Dennis40816/hand_pcb/pcb/hand_sensor_origin_footprint_v1/fabrication_files/hand_fpc_v1_bom.xlsx

Comment | Designator | Footprint | Supplier Part
4.7uF | C31, C47 | C1206_FPC | C29823
22Ω | R29, R30, R31, R32, R33 | R1206_FPC | C17958
100nF | C26, C27, C28, C29, C30, C32, C33, C34, C35, C36, C37, C38, C39, C40, C41, C42, C43, C44, C45, C46 | C1206_FPC | C24497
B54102H1020A001 | U9, U11, U21, U22 | B54102H1020A001 | C17316382
BMI323 | U15 | BMI323 | C5368700
CH 101 02ABR | U8, U14, U16, U20 | XDCR_CH-101 | C1513113
KX132-1211 | U12, U13, U17, U18 | LGA-12_L2.0-W2.0-P0.50-TL | C2157931
VL53L1CXV0FY/1 | U10, U19 | SENSOR_VL53L1CXV0FY/1 | C190004
