Dennis40816/hand_pcb/pcb/fabrication/README.md

# Fabrication Readme

## Gerber

- The Altium Designer file for the sensor board is directly submitted for fabrication. Therefore there's no gerber files for sensor board.

## Stencils

- The file to fabricate stencils, provided from JLC.

## AD Zip

- The backup for pcb project files
