Dennis40816/hand_pcb/design_guide/HAND design guide.pptx

## HAND 設計詳解

2024/05/06
製作人: 劉尚賢

## 總述

- HAND 是一款結合超聲波感測器、ToF、壓電致動器、IMU等功能的感知回饋系統，旨在以觸覺方式提醒周圍是否有異物，及相關附加功能
- HAND: Haptic Asistance Nevigation Device
- HAND 分成主板(hand_main)以及 FPC (hand_fpc)
- Hand_main 又可以分成 Main 區域(主要功能區)和 PDN (Power Delivery Network)區域

## HAND PDN USB Connector

## Slide 4

OUT: 通常指上位機
IN: 通常指嵌入式設備端

參考 layout

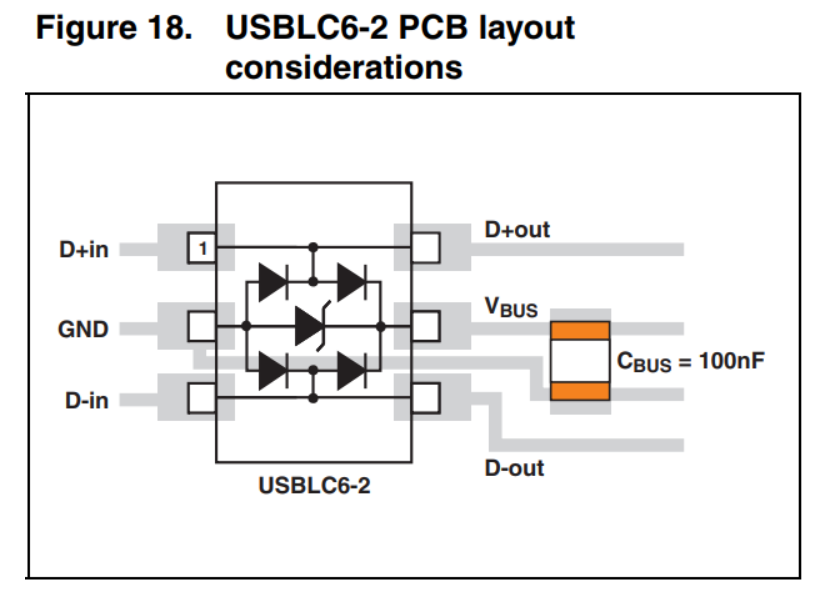
[picture p7: figure]
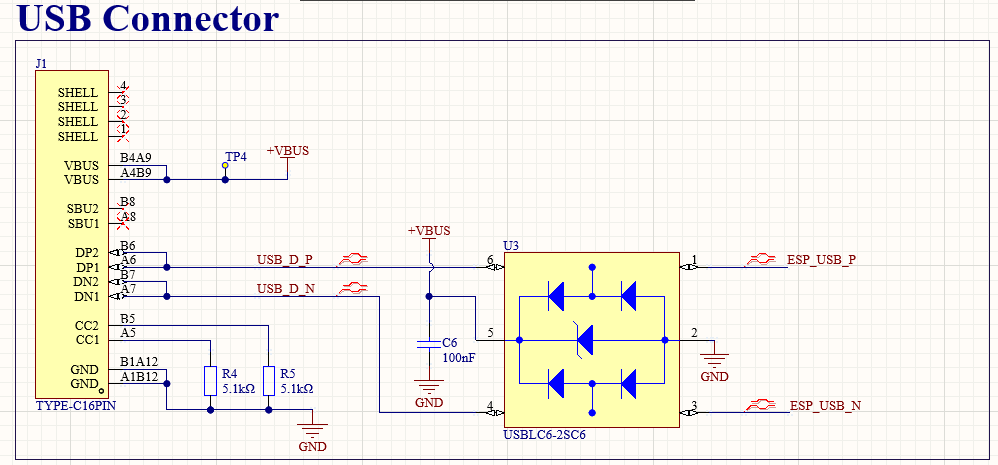
[picture p8: figure]

CC1, CC2 Rp 電阻，用於表示汲取電壓電流範圍，5.1k 表示 5V3A (不用任何通訊，前提是上位機支持)

Type-C 母接頭

USB Data line ESD 保護

D+, D- 差分線

C6

往 ESP32 的 USB 差分線

## HAND PDN Battery Charger

## Slide 6

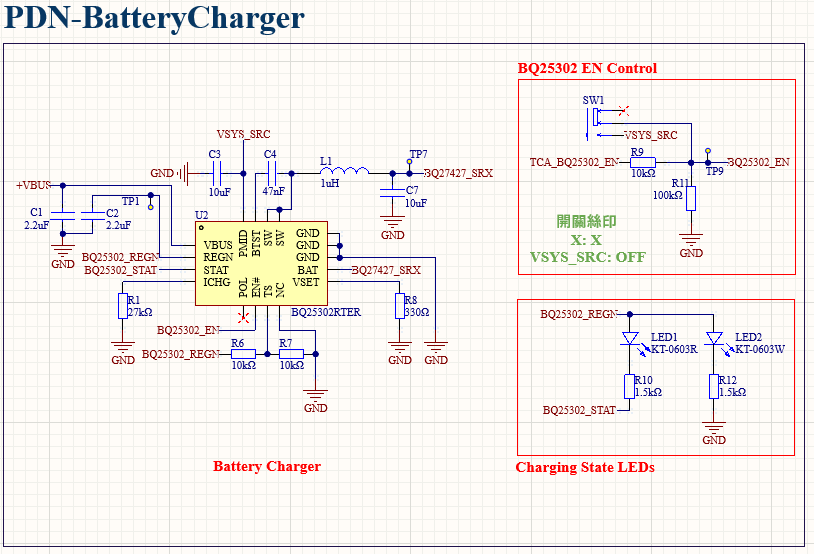
[picture p9: figure]

需與 Fuel Gauge 一起觀看

OVERVIEW

- 使用 BQ25302 作為電池充電的管理 IC
- 該 IC 可以設定充電電壓 (此處為 4.2 V) 和電流 (此處約 1.5A Max)
- 輸出至 PDN 的 net name 為 BQ27427_SRX
- 該 IC 可以藉由右側的開關決定是否啟動

BQ25302 (https://www.ti.com/lit/gpn/bq25302) (https://www.ti.com/lit/gpn/bq25302)datasheet (https://www.ti.com/lit/gpn/bq25302)

DATASHEET

TI E2E: BQ25302 sch review (https://e2e.ti.com/support/power-management-group/power-management/f/power-management-forum/1349813/tps63806-tps63806-bq25302-bq27427-schematic-review/5157413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)

可以查看 Figure 9-6

## About Settings…

電壓設置

電流設置

根據手冊，充電的最高電壓值由 VSET 腳位對地的電阻決定，此處選用 330 Ohm (R1) 使電壓設定成 4.2 V。
另外值得注意的是，VSET 直接接地和浮接好像會有問題。

根據手冊，充電的最高電流值由 ICHG 腳位對地的電阻決定，此處選用 27k Ohm (R8) 使電壓設定成 40,000(KICHG) / 27,000 = 1.48A。
另外值得注意的是， ICHG 直接接地和浮接好像會有問題。

## Slide 8

這個 EN 控制電路集合了硬體和軟體能夠對 BQ25302_EN 進行控制

當 SW1 在常開側，開關浮接，此時 BQ25302_EN 可以由 TCA_BQ25302_EN 的電位決定 (由 10k 和 100k 分壓可知)，當 SW1 切換到 VSYS_SRC (> 3.3V)，則 BQ25302_EN 被強上拉，強制關閉 (BQ25302 是低電位始能)

BQ25302 的 REGN 是其內部 5V 的 LDO 輸出，負責 LED 供電 LED 狀態燈，閃爍情況請見手冊

電容和電感請參考手冊選值 (Table 6-1. Pin Functions)

Default pull
down resistor

手冊提到當 TS沒有用到時，要透過 10k 電阻連接

## HAND PDN Fuel Gauge

## Slide 10

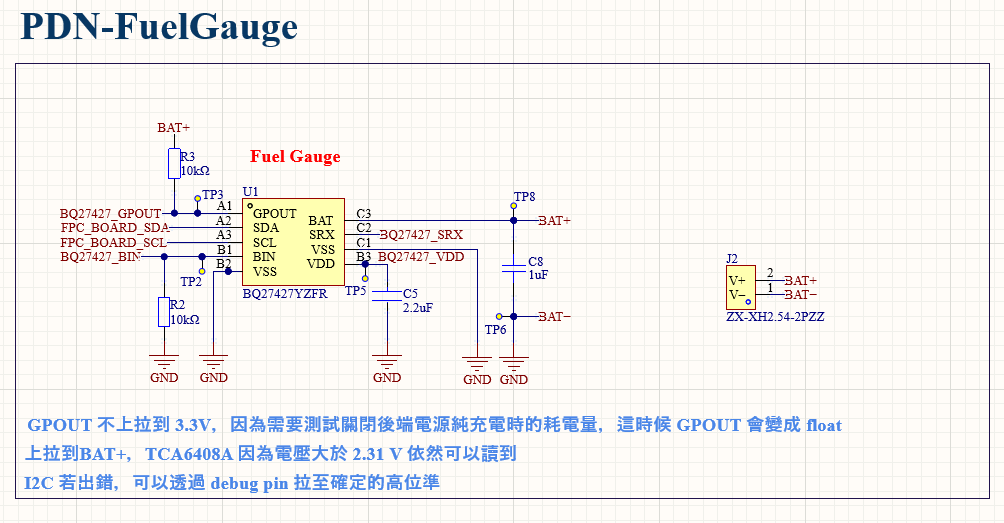
[picture p10: figure]

上拉到 BAT+ 而非 3.3V 原因下面有寫，BAT+ 沒接的時候也不重要，因為 BQ27427 不會啟動

Fuel gauge 是用來查看目前剩餘電量的 IC，BQ27427 裡面自帶電流量測電阻(在 BAT 和 SRX 之間)，最大的電流為 2A RMS

可使用 I2C 跟 MCU進行溝通，請注意只有當電池插入時，I2C 才是可用的

SRX 是對外的接口，所以跟充電 IC 連接

偵測電池是否插入
沒有用的時候使用 10k 下拉

BQ27427 datasheet (https://www.ti.com/lit/gpn/bq27427)

## HAND PDN Load Sharing

## Slide 12

Back to back (https://electronics.stackexchange.com/a/428175)pmos (https://electronics.stackexchange.com/a/428175)

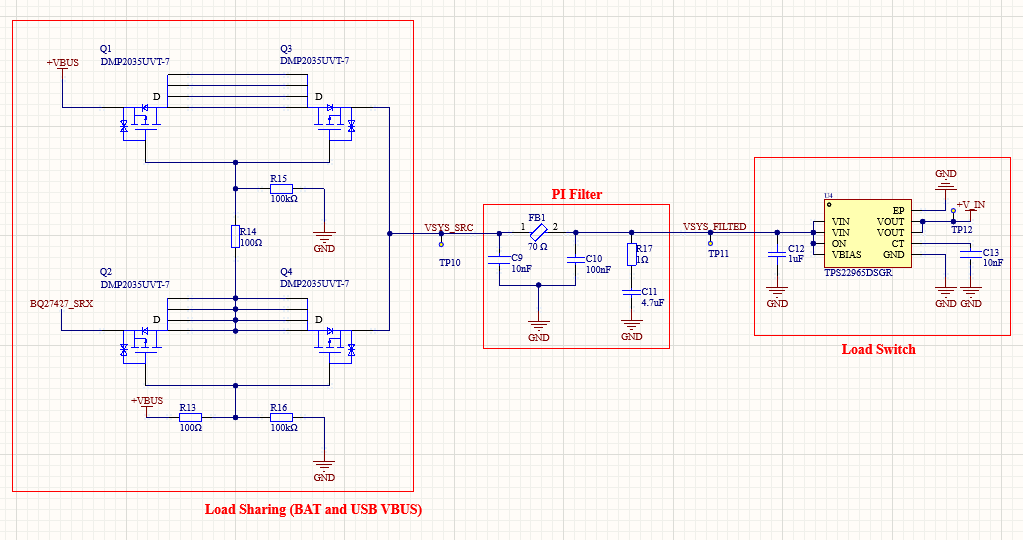
[picture p11: figure]

Back to back pmos 相較於 pmos + 蕭特基二極體的方案具有更低的損耗，在此 VBUS 優先使用，如果沒插才換 BQ27427_SRX

這主要是防止上電時出現 inrush current，尤其是對 USB 而言

防止 gate inrush current

Pi filter 用於過濾高頻，R17 和 C11 是用於抑制前面 pi filter 的共振頻率(見後)

C13 控制延遲時間，對於 3.3V 約為 11 ms，5V 約為 19ms

TPS22965 datasheet (https://www.ti.com/lit/gpn/tps22965)

確保未插入時的電位為低 避免意外導通

## 有關原理與損耗 …

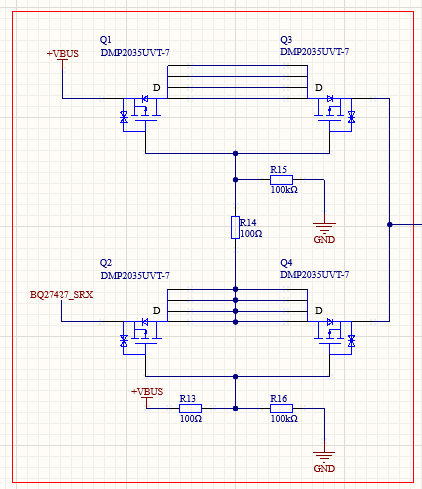
[picture p12: figure]

D

USB 插入

損耗

S

S

- 當 USB 插入，+VBUS 生壓至 5V，此時，原本打開的 BQ27427_SRX 會開始關閉(因為 VGS 不再 < Vth, 注意 PMOS 的 Vth 為負值，要 < Vth 才會導通!!)
- 當下方的 PMOS 管關閉後，電壓會被拉至 Default 0V，此時，上方的 VGS 就會低於 Vth ，因此上方導通

與第一個版本相比(見 A.1 章節)，這個版本在 3A 的電流下，功耗是 3*3*0.09 ~ 0.81(W)，0.09 (Ohm) 是兩個 PMOS 的 Rd(on) 總和

第一個版本則是 3*3*0.045 + 0.55 (Vf, 正向壓降) * 3 = ~ 2 (W) 的損耗，目前版本的能量耗損提升 60%

G

D

S

G

S

## Pi Filter

USB Pi filter: (https://electronics.stackexchange.com/questions/648984/usb-2-0-vbus-filter)好文推薦 (https://electronics.stackexchange.com/questions/648984/usb-2-0-vbus-filter)

- USB 電源常具有高頻分量，為避免影響電源穩定性，我們會使用 Pi filter 進行電源濾波
- 為甚麼需要 Pi filter? 因為ㄧ般低頻分量(< 1MHz)，LDO 可以很好的電源抑制比(PSRR, 20 dB to 60dB)，然而，LDO 無法對更高頻的紋波有好的抑制效果，而開關電源更是如此(本身用 1M 左右頻率開關)，因此需要 Pi filter 防止高頻分量藉由 VBUS 進入或離開系統
- Pi filter 本質上是 LC 濾波器，LC 會有共振頻率，因此需要藉助後面的 RC filter 降低尖峰處 (見 Simulation 章節 – Pi filter)
- 不可以加在 USB 的 D+, D-
- 不適合用做”輸出濾波器”，這就是為甚麼通常放在電源入端

## 為甚麼使用磁珠而非電感

- 電感多由繞多圈電線產生的，當闸數越多，寄生電容越高，因此到達一個頻率(e.g., 100MHz)便沒有辦法繼續濾波，但磁珠的原理是透過磁芯損耗，因此工作頻率能比電感更高
- 磁珠的頻譜-阻抗圖類似右圖，在低頻像電感
高頻則像是電阻
- 請注意，如果是要過濾開關電路，則電感較為
推薦，因為磁珠在 < 50MHz 幾乎不工作

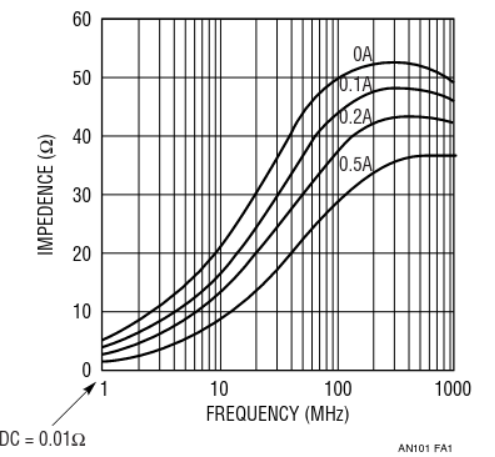
[picture p13: figure]

## HAND PDN Buck Boost Converter

## 功能說明

- 主要是為了主系統提供 3.3V，以及產生 1.8V 給 CH-101

## Slide 18

Buck Boost PG

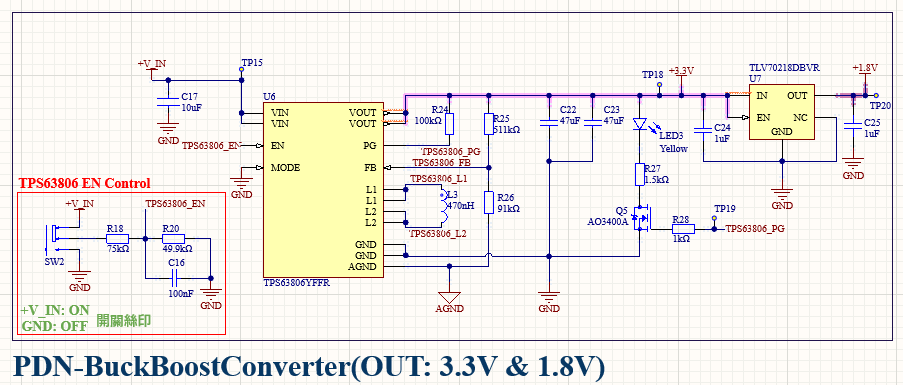
[picture p14: figure]

Buck Boost Converter (產生 3.3 V)

1.8 V LDO

可以參考 delay startup (https://www.ti.com/lit/pdf/slvaea3) 和 threshold start up (https://www.ti.com/lit/pdf/slvae79) 兩篇文章

藉由 power good 和產生的電壓決定 LED 的亮暗，如果暗表示電源出問題
注意 NMOS body diode 不能反向

2.8 V Vin 啟動

## HAND PDN Boost Converter

## 功能說明

- 主要是為了BOS1901 的 VDD (非 VDDIO) 給壓電馬達供電
- 強烈建議觀看 layout (https://www.ti.com/lit/pdf/slvaes4)說明書 (https://www.ti.com/lit/pdf/slvaes4)
- Review: TPS61023 (https://e2e.ti.com/support/power-management-group/power-management/f/power-management-forum/1350697/tps61023-tps61023-schematic-review/5159138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)

## Slide 21

開關電路的電感，其飽和電流要夠大，建議按照手冊挑

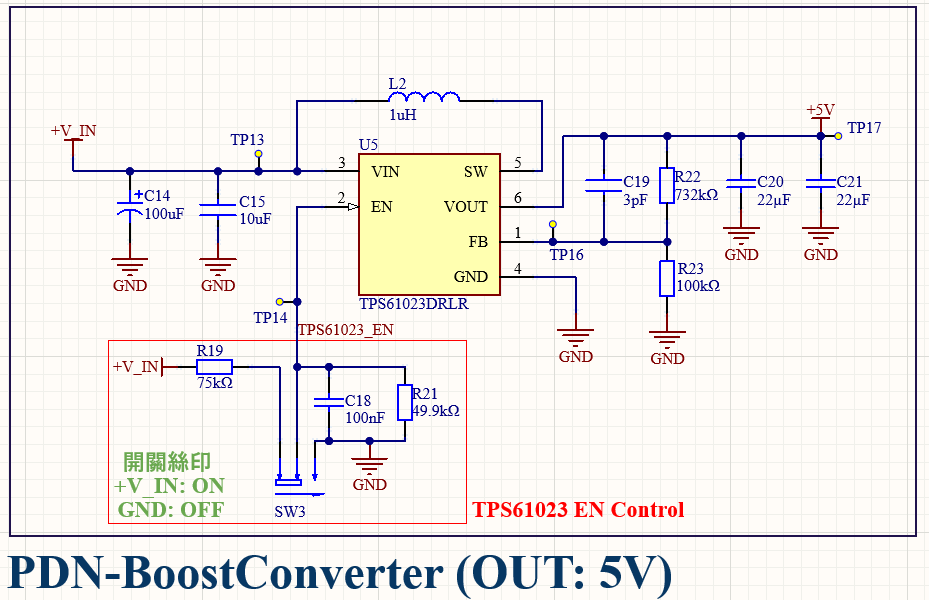
[picture p15: figure]

如果電源不穩定可以加上這個電容 (datasheet 說的)

Feedforward capacitor (https://www.ti.com.cn/cn/lit/pdf/zhca058)

跟 TPS63806 一樣的啟動電路，值得注意兩者的 EN 啟動電壓閾值並不一樣(見 Simulation - PDN)

電源紋波量測 (https://zhuanlan.zhihu.com/p/680857598)

TI (https://e2echina.ti.com/cfs-file/__key/telligent-evolution-components-attachments/00-24-01-00-00-36-63-77/TI_2D008259554F636B6E784B6DD58B3575906E8476B97EE26C1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)量測電源紋波 (https://e2echina.ti.com/cfs-file/__key/telligent-evolution-components-attachments/00-24-01-00-00-36-63-77/TI_2D008259554F636B6E784B6DD58B3575906E8476B97EE26C1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)

## HAND PDN Simulation

## PI filter

## Slide 24

Simulation in ADS

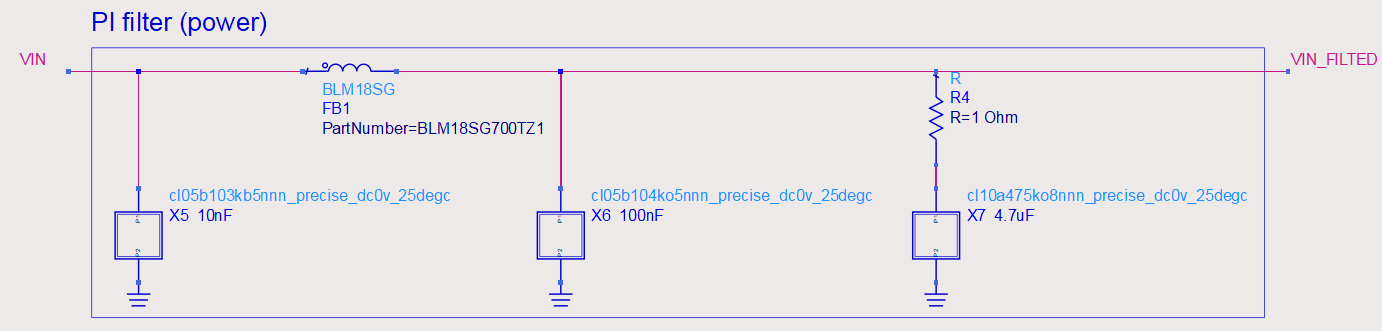
[picture p16: figure]
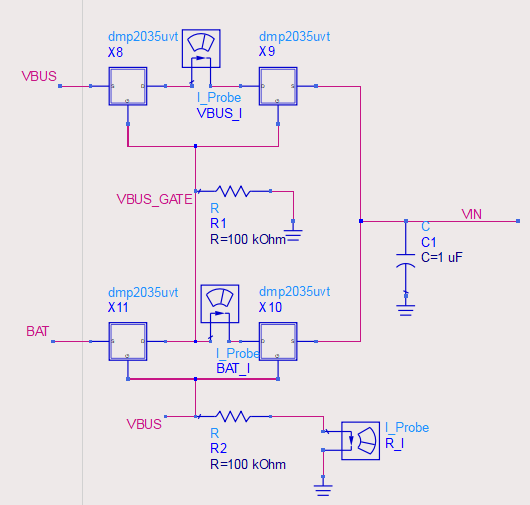
[picture p17: figure]

back to back pmos (load sharing)

Pi filter

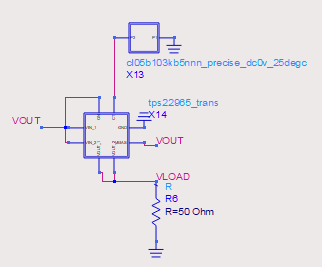
[picture p18: figure]

v

Power

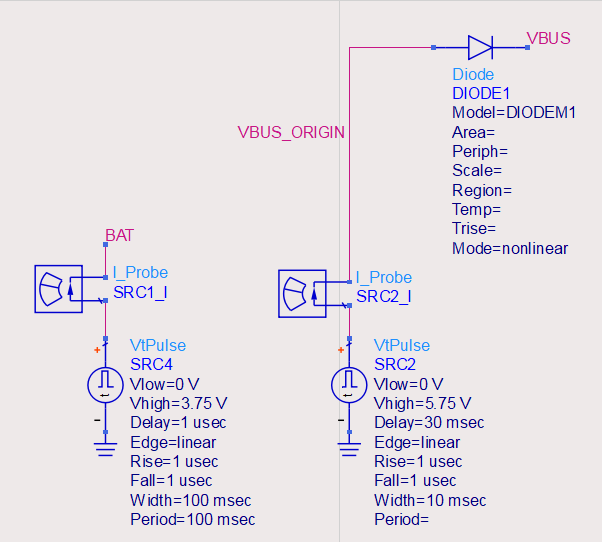
[picture p19: figure]

v

Load switch

## Slide 25

Frequency Response in ADS

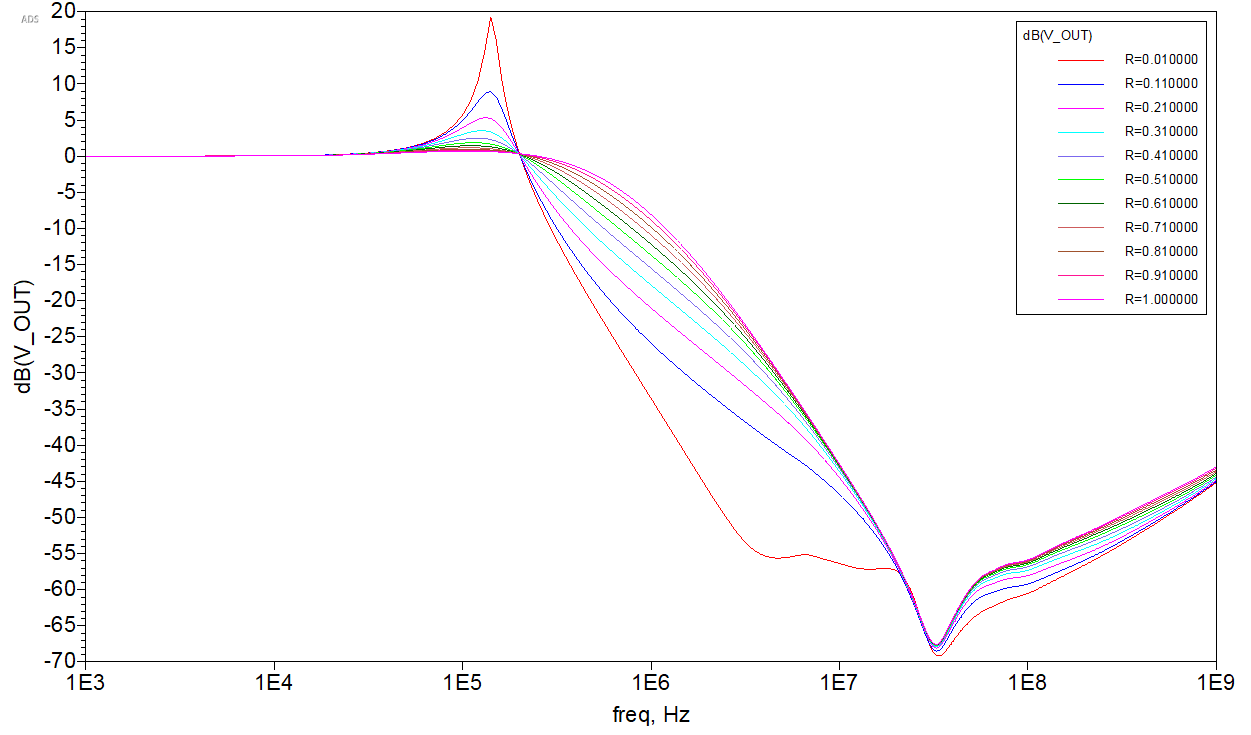
[picture p20: figure]

LC resonant

R = 1 Ohm

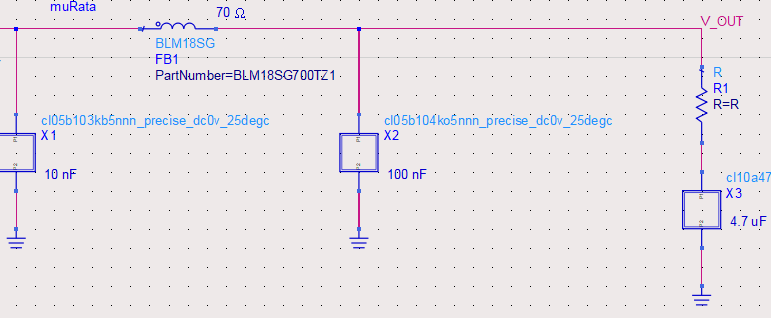
[picture p21: figure]

L

R

C

## PDN Simulation

## 請參考前方設計 SCH 觀看

## Slide 28

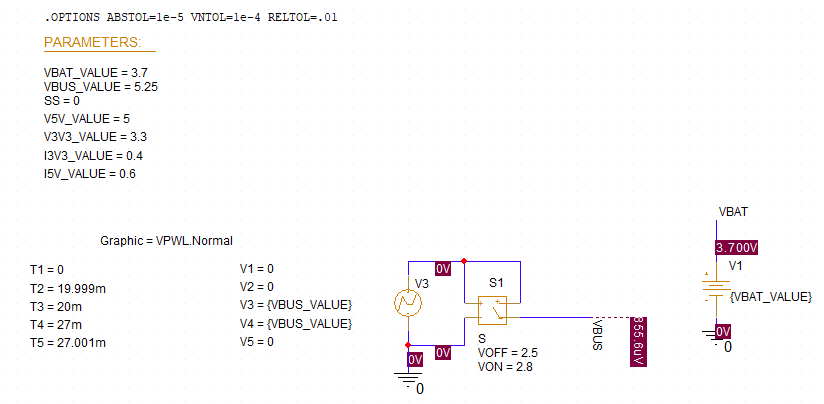
[picture p22: figure]
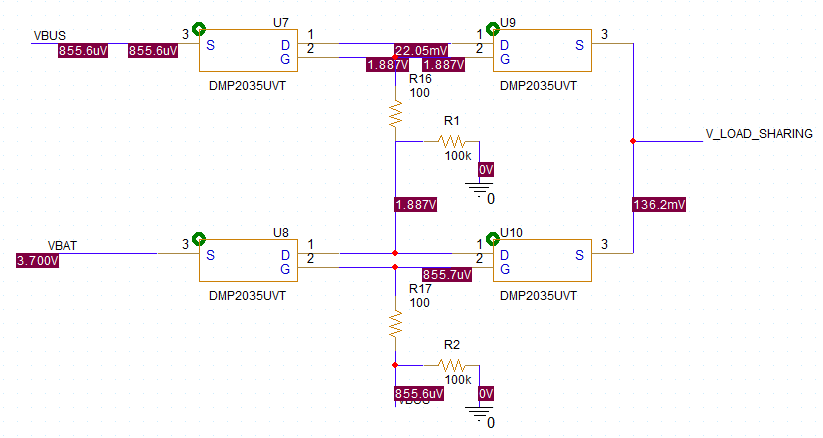
[picture p23: figure]

Settings

Load Sharing

Power

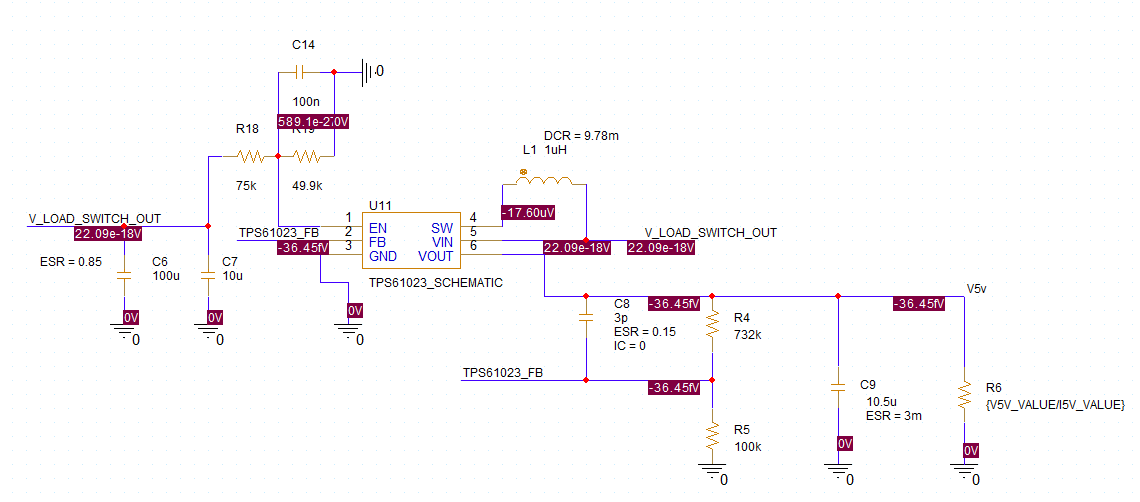
[picture p24: figure]

TPS61023

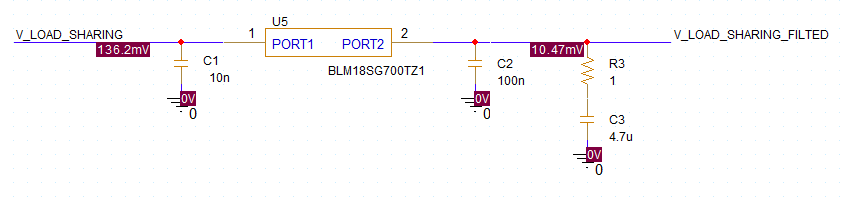
[picture p25: figure]

Pi filter

## Slide 29

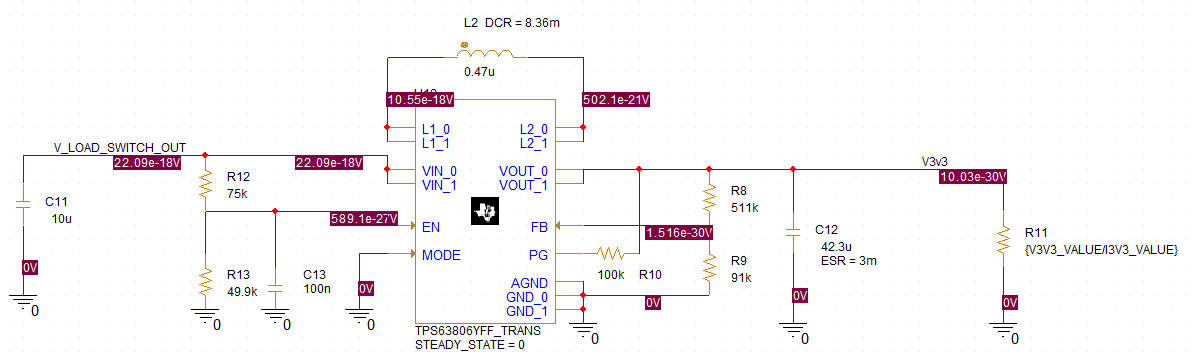
[picture p26: figure]

TPS63806

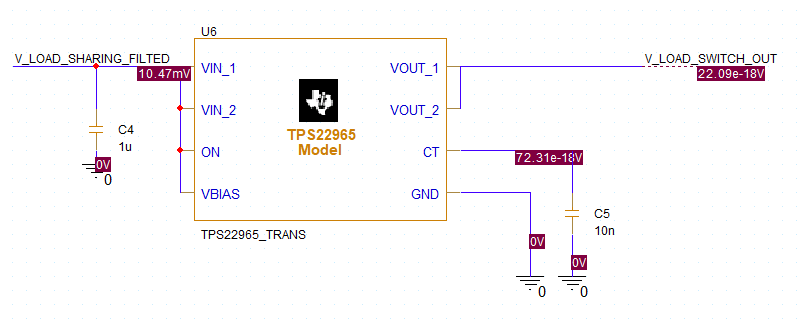
[picture p27: figure]

Load Switch

## Simulation Args

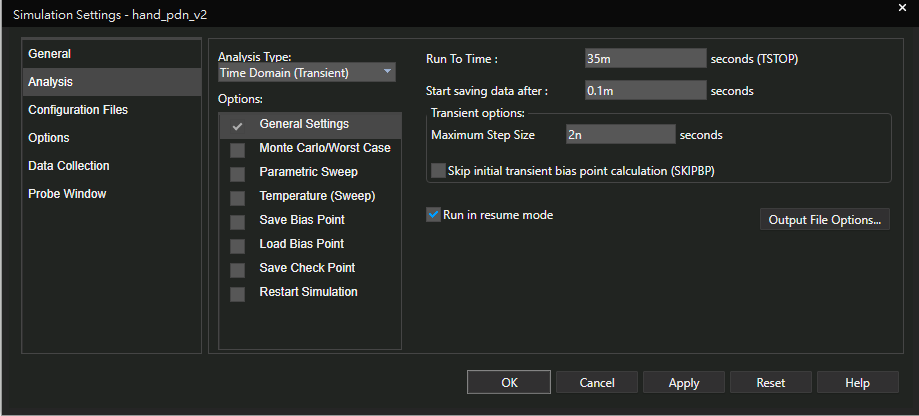
[picture p28: figure]

這個一定要夠小

## Slide 31

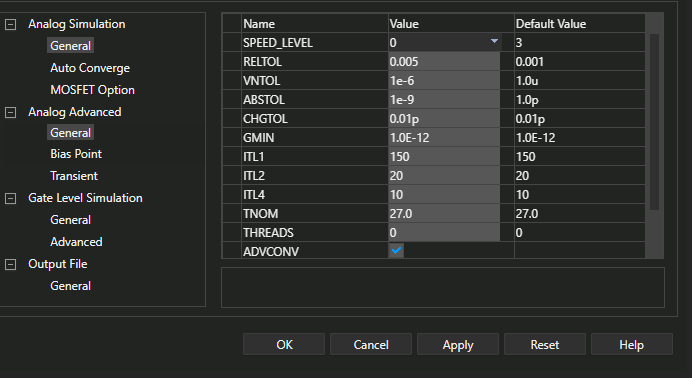
[picture p29: figure]
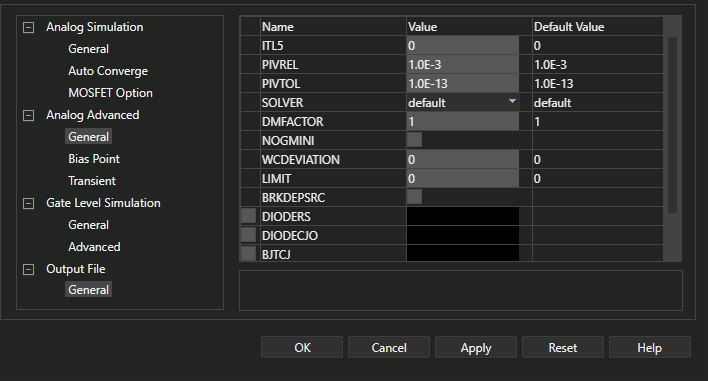
[picture p30: figure]
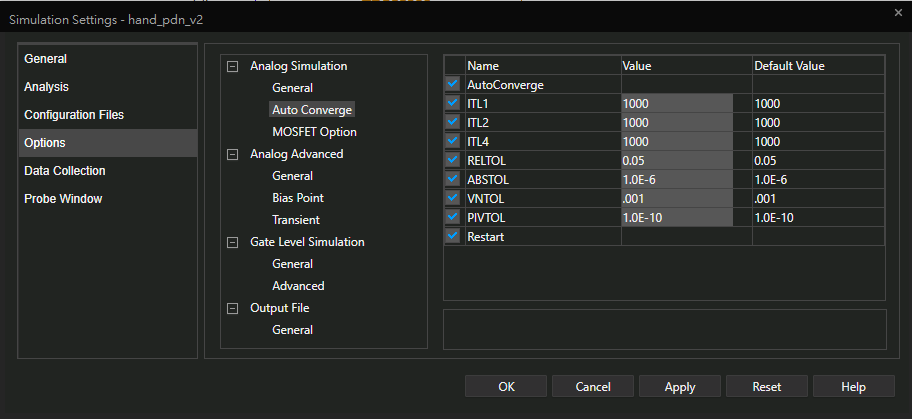
[picture p31: figure]

## Result

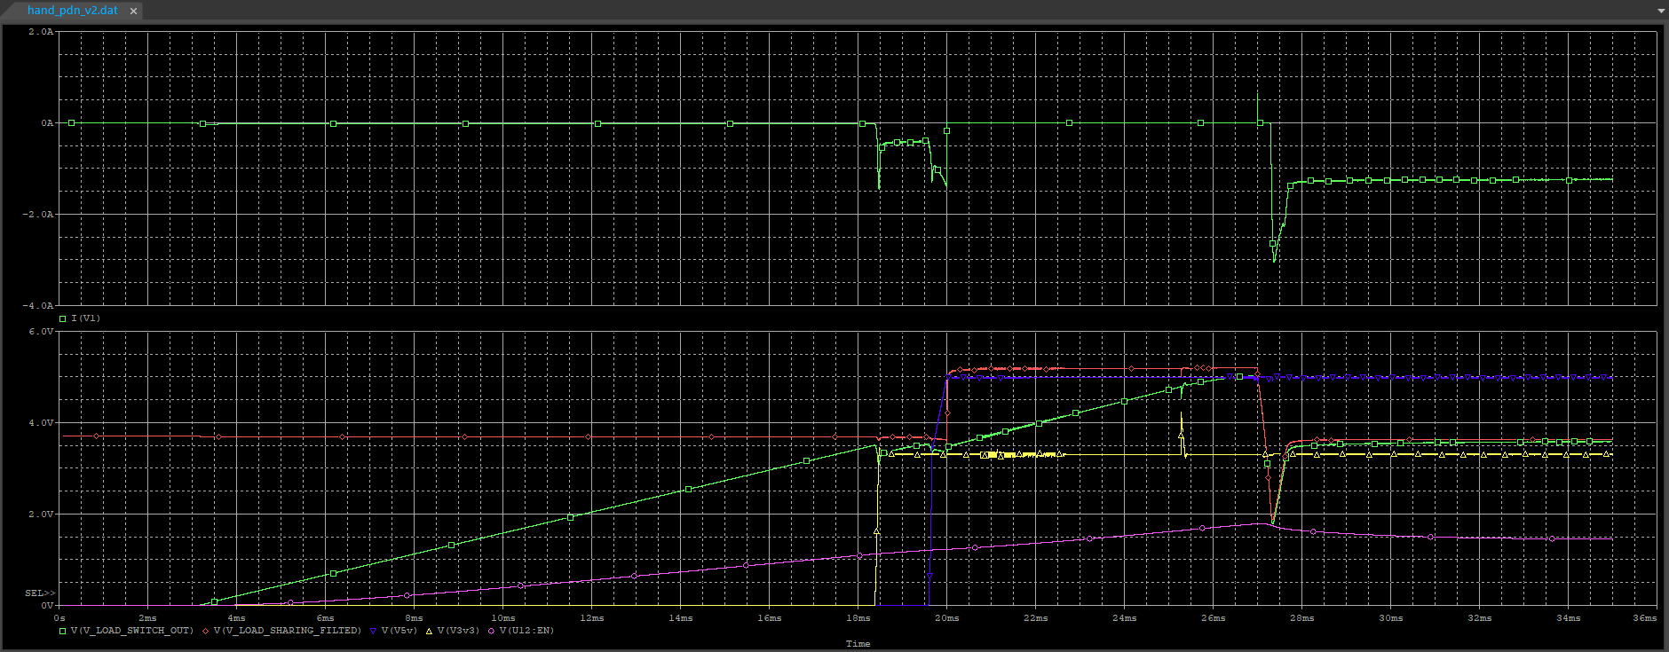
[picture p32: figure]

Battery 電流

USB Plug

USB Unplug

## HAND PDN Main – ESP32S3

## Slide 34

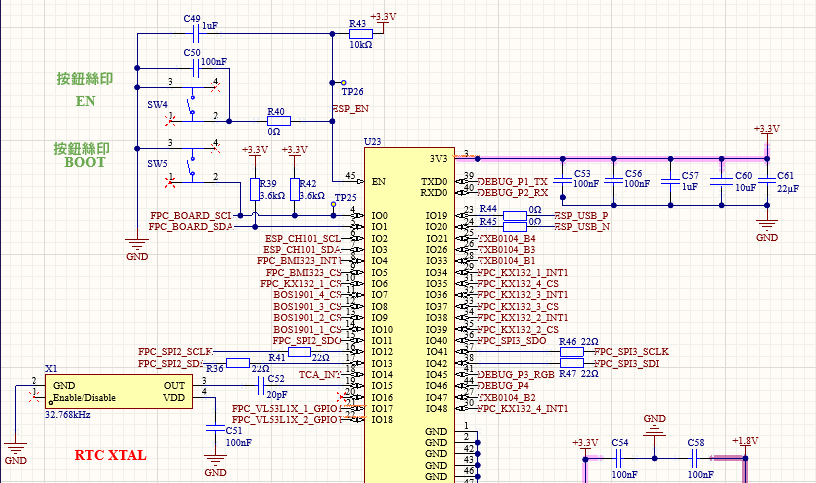
[picture p33: figure]

EN delay circuit @上電 (參考 datasheet)

EN 按鈕 debounce@上電 (參考 datasheet)

# 如果是無源晶振就 15, 16 腳都要接

- 腳位功能需要查看手冊
- ESP32 S3 所有腳位應該都可以當作 output
- 要特別小心 IO0, IO1, IO45, IO46 等 boot strap 腳位的初始狀態，避免因為錯誤的外部上下拉導致無法啟動

Decoupling capacitors

有源RTC晶振

## Slide 35

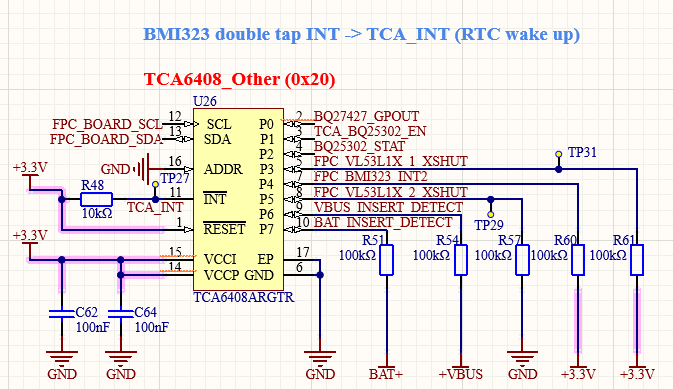
[picture p34: figure]

BMI323 的中斷會引發 TCA6408的中斷，接著引發ESP32 的中斷，可以由睡眠中喚醒

INT就算不用都要上拉或下拉

VL53L1X 的 XSHUT 一個預設開啟一個預設關閉的原因是兩者 I2C 的地址相同需要先修改一個

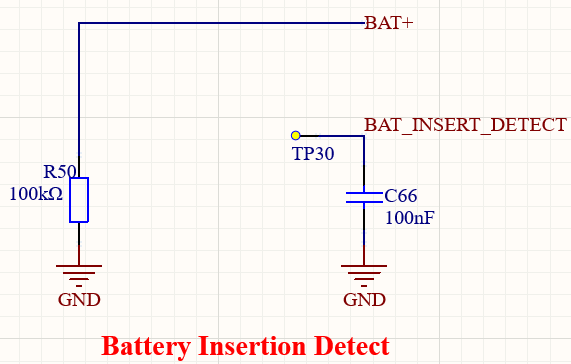
[picture p35: figure]

偵測 USB 和 BAT 插入

## Simulation – detect battery

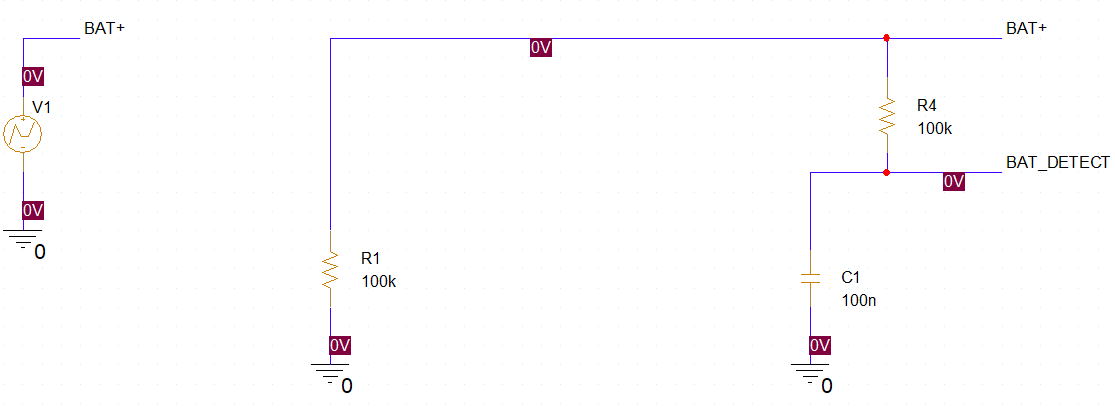
[picture p36: figure]

Simulation

## Slide 37

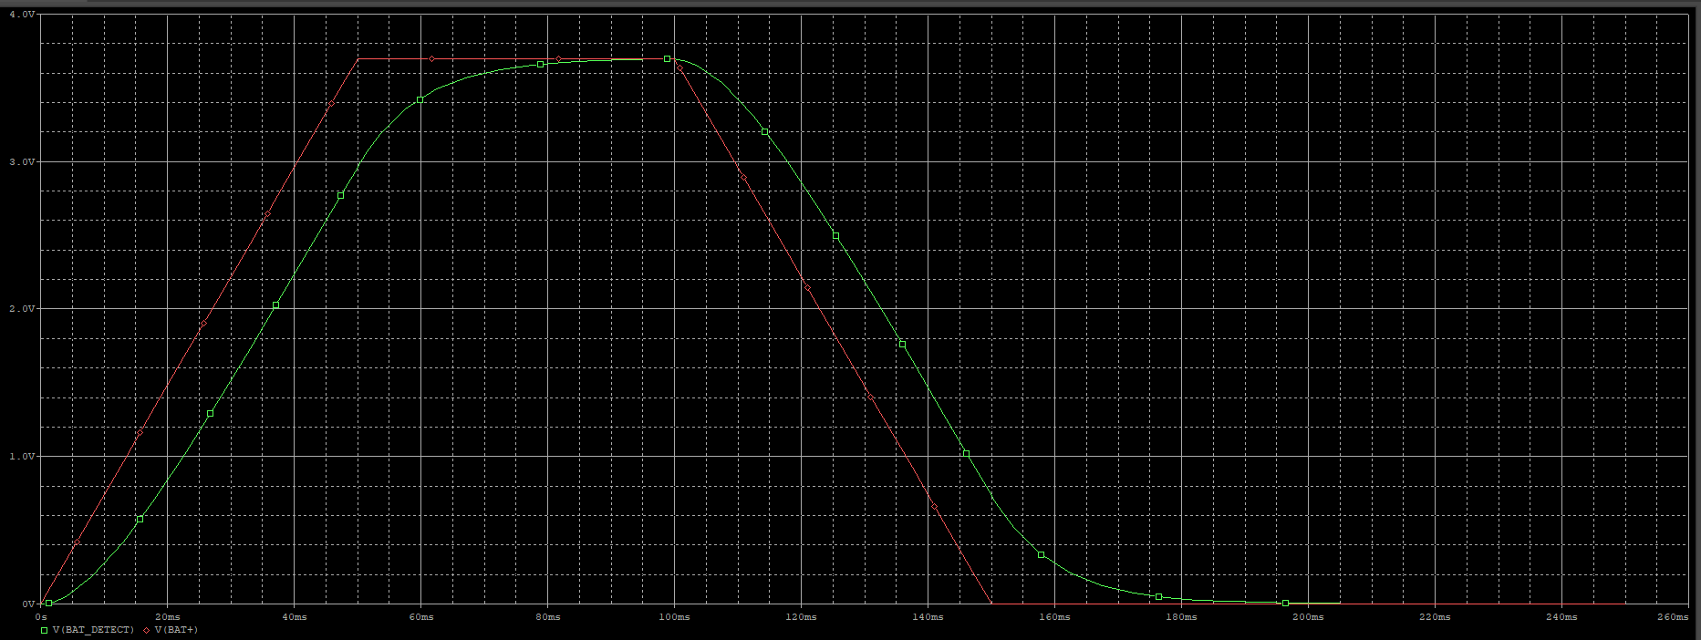
[picture p37: figure]

## 剩餘部分

- 剩下都是參考手冊進行設計

## 蕭特基 diode + PMOS 的 Load Sharing (Load Sharing V1)

## Load Sharing Circuit

Loading sharing circuit (https://www.best-microcontroller-projects.com/tp4056-page2.html)

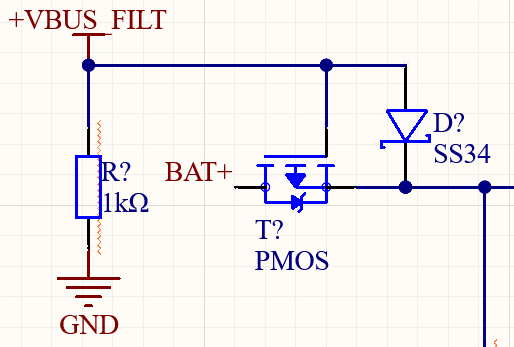
[picture p38: figure]

BAT+(VD)@2.7V | -1.9V ~ -1.5V
BAT+(VD)@4.2V | -3.4V ~ -3V

當 VBUS 未接入時

- VBUS_FILT 會被下拉到 GND，此時 PMOS 處的 VG = 0V，VS(VLoad) = 0V。
- 然而，VD = BAT+ 是電池的電壓，由於VDS > 0.7 V，因此下方的體二極體會導通，此時，VS的電壓會變成 VD – 0.8 ~ VD – 1.2 (V)，此時允許的最大電流記做 IS
- 由於上述的改變，使 VGS 也改變了，電池電壓約為 2.7 – 4.2 (V)，所以VGS的範圍是 -1.9V ~ -1.5V，比 VGS(th)更負，此時 PMOS 導通，電池的電流開始由 Rds(on) 流往 Vload
- 值得注意的是，SS34 會有漏電流(見下一張投影片)

G

VLoad

下拉電阻

D

S

體二極體

SI2301CDS-T1-GE3

SI2301CDS-T1-GE3 (PMOS)

## Load Sharing Circuit

下拉電阻 (https://murata.eetrend.com/article/2019-11/1003145.html)

MDD, SS34

- SS34 允許最大 40 V 的 reverse voltage，VS 最大的值在PMOS 導通後為 VD – Rds(on) * Id，HAND 系統 Id 最大應不超過 2 A(此處使用 2.8A 計算)，透過左圖得知在 VS = 4.2 – 0.112*2.8 = 3.87 (V)，約為 40 V 的 1/10，在 75 度約為 0.1 mA，因此 VBUS_FILT 會被下拉電阻拉升至 0.1 mA * 1k ohm = 0.1V，這個值也會影響到 VG，所以要謹慎挑選下拉電阻值(這個只是初步估計)

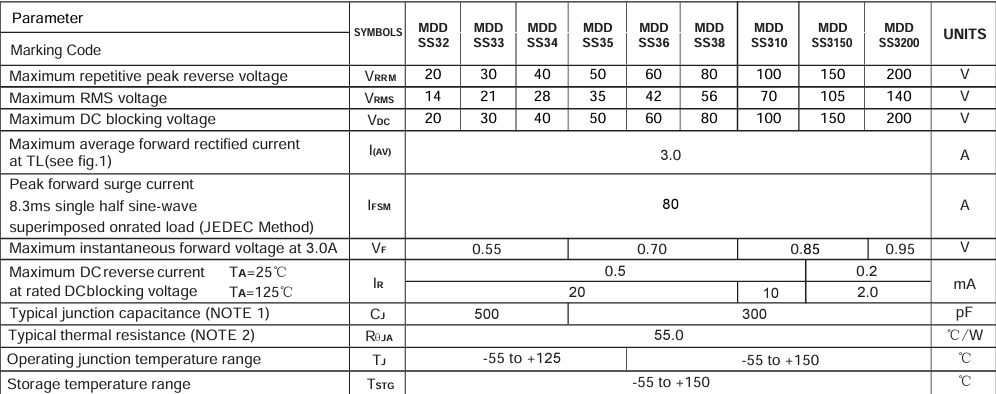
[picture p39: figure]
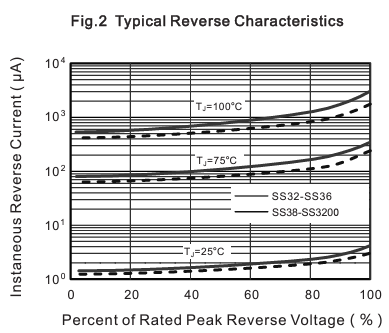
[picture p40: figure]

~0.1 mA

## Load Sharing Circuit

當 VBUS 接入時

- VBUS_FILT = 5V，此時 SS34 導通，而 PMOS 由於VGS = 0V 所以關閉(避免回流至電池)
