Dennis40816/hand_pcb/pcb/hand_sensor_origin_footprint_v1/fabrication_files/金手指補強文檔.docx

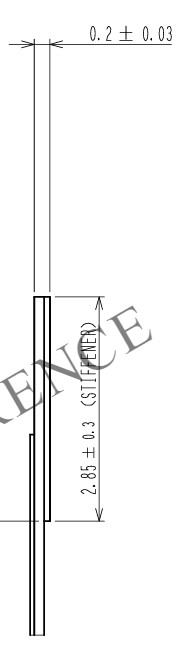
[picture p41: figure]

45 Pin 官方文件 (https://www.hirose.com/en/product/document?clcode=CL0580-2909-6-50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)中的厚度圖

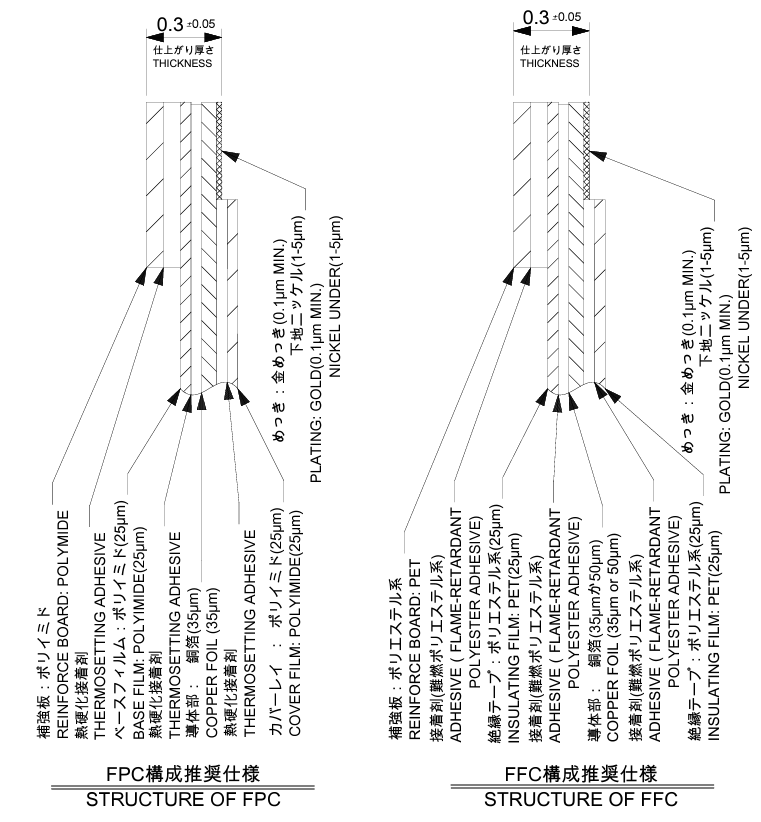
[picture p42: figure]

24Pin 官方文件 (https://www.molex.com/content/dam/molex/molex-dot-com/products/automated/en-us/salesdrawingpdf/522/52207/522072460_sd.pdf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)的厚度圖

JLC 計算結果:

(24Pin-0.mm3厚度)

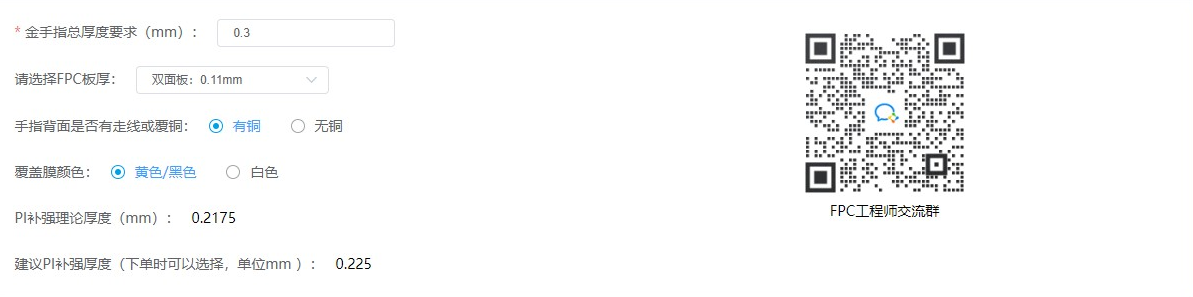
[picture p43: figure]

(45Pin-0.2mm 厚度)

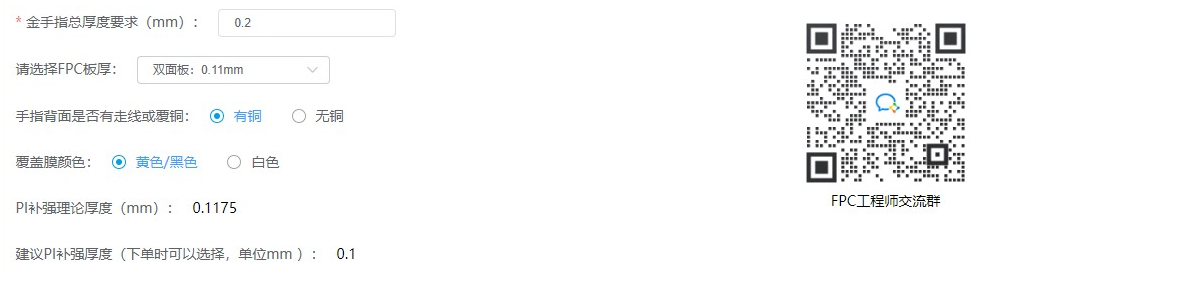
[picture p44: figure]
