Dennis40816/hand_pcb/(list of files, drawings)

Other design files:
pcb/hand_main_board_v2/hand_ad_lib/hand_ad_lib.SchLib
pcb/hand_main_board_v2/hand_main_v2.PrjPcb
pcb/hand_main_board_v2/hand_main_v2.SchDoc
pcb/hand_main_board_v2/hand_pdn_v2.SchDoc
pcb/hand_sensor_origin_footprint_v1/hand_fpc.PcbLib
pcb/hand_sensor_origin_footprint_v1/hand_fpc.SchDoc
pcb/hand_sensor_origin_footprint_v1/hand_fpc_v1.PrjPcb
